NikosLabs/nikoslabs.github.io/articles/am-radio/article.md

---
title: Build an AM Radio!
date: 2026-07-29
author: DemodulatedWave
tags: Radio, AM, Intermediate, Analog, Tutorial, RF, Theory
description: A guide to build a simple AM radio receiver.
image: assets/placeholder.jpg
hidden: true
---

# Getting Started: AM Radio
I will go over how to make a simple AM radio with minimal components and explain how each part works.

## What You'll Need

- Bread board
- AM Antenna or long wire
- Magnet Wire and rod (wood, pvc pipe, but no metal) or Inductor Kit
- Electrolytic Capacitor and Ceramic Capacitor Kit
- Resistor Kit
- Germanium Diode
- Speaker (2Ohm is good)
- 1x LM386 module
- 9V Battery
- (Optional) 3 way guitar switch
- (Optional) On/Off switch (SPST)
- (Optional) 10k logarithmic potentiometer

## Circuit Diagram

Here's the basic circuit we will be looking at:

Graph screenshot

## How It Works

## Antenna

## LC Tank
**How it works**
It can be calculated with:
$$f_0 = \frac{1}{2\pi \sqrt{LC}}$$

**Inductor**
**Capacitor**

## Demodulation
**What is an Envelope detector?**
$$\frac{1}{f_c} \ll RC \ll \frac{1}{f_m}$$
**Diode**
**Resistor**
**Capacitor**

## Amplification
**LM386**
**Importance of Decoupling**

## Troubleshooting

**Static?**
**Hear Nothing?**
**Tuning but no stations?**
**Hand detuning?**

## Next Steps

- Try to tweak inductor values to find more stations
- Make your own specialized AM Antenna
- Make a cool housing for your radio with wood, 3d printing, etc
- If you used an inductor kit, try winding your own inductor!

Enjoy listening to your new home-made AM radio!
