NikosLabs/nikoslabs.github.io/articles/beauty-of-interstellar/article.md

---
title: The Beauty of Interstellar
date: 2026-07-31
author: Niko
tags: Movie, Interstellar, Opinion
description: My takes on Interstellar by Christopher Nolan
image: assets/interstellar.jpg
hidden: true
---

> [!NOTE]
> **SPOILER ALERT** If you haven't watched the movie, go watch it! Then, you can come and read this! Trust me you don't want it spoiled ;)
> ‎ 
> ‎ 
> ‎ 
> ‎ 
> ‎ 

## Why It stands out

For a voltage divider with resistors R₁ and R₂:

## Related Books
Interstellar has a few amazing related books. I've read two of them this summer: *Interstellar: The Official Movie Novelization* by Gregory Keyes and *The Science of Interstellar* by Kip Thorne
### *Interstellar: The Official Movie Novelization* by Gregory Keyes
Placeholder
### *The Science of Interstellar* by Kip Thorne
Placeholder

## Conclusion

Interstellar is a masterpeice.
