NikosLabs/nikoslabs.github.io/assets/laser-radio-header.jpg

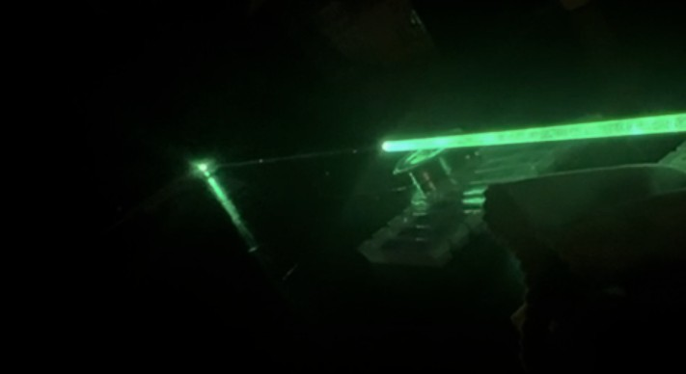
assets/laser-radio-header.jpg
