NikosLabs/nikoslabs.github.io/assets/laser-radio/BoothPhoto.png

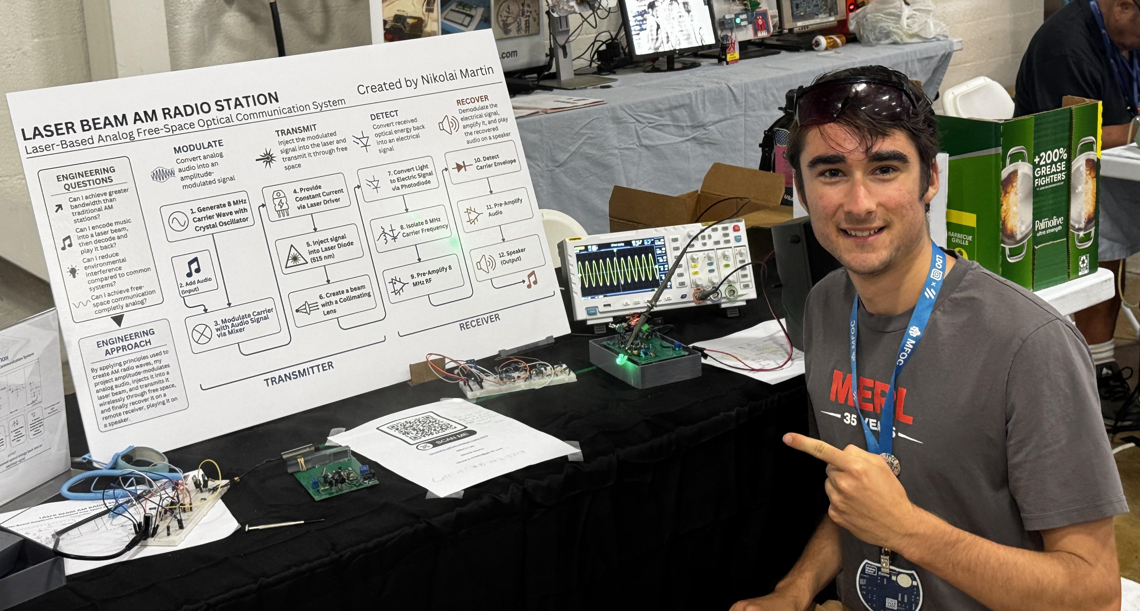
assets/laser-radio/BoothPhoto.png
