NikosLabs/nikoslabs.github.io/assets/laser-radio/breadToPerf.png

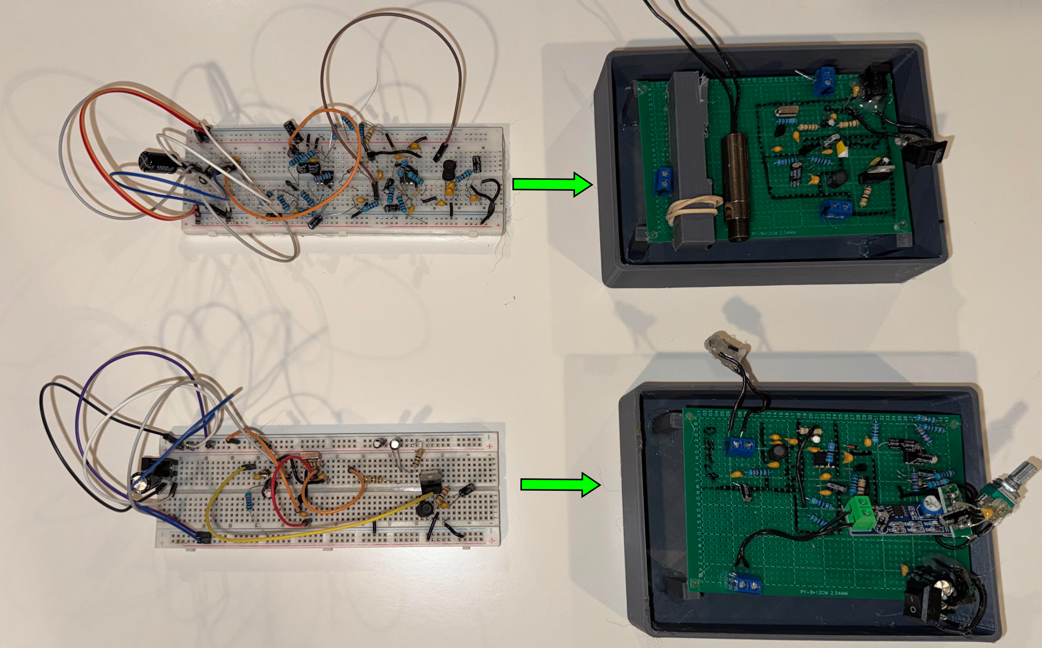
assets/laser-radio/breadToPerf.png
