NikosLabs/nikoslabs.github.io/assets/laser-radio/coverForDemo.png

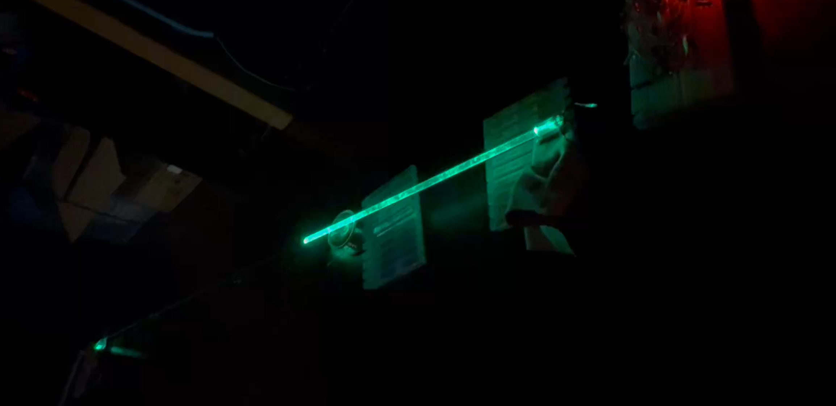
assets/laser-radio/coverForDemo.png
