NikosLabs/nikoslabs.github.io/assets/laser-radio/DetectSchematic.png

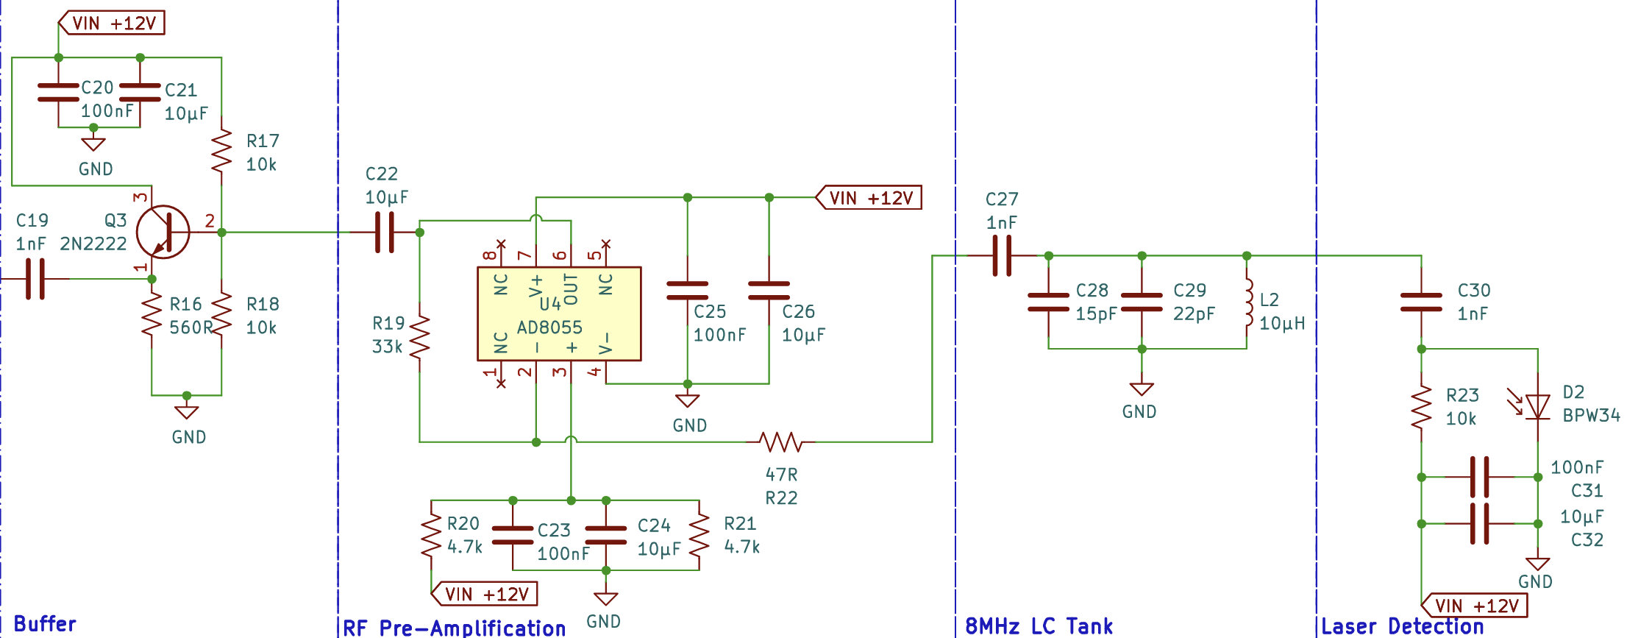
assets/laser-radio/DetectSchematic.png
