NikosLabs/nikoslabs.github.io/assets/laser-radio/laserholder.png

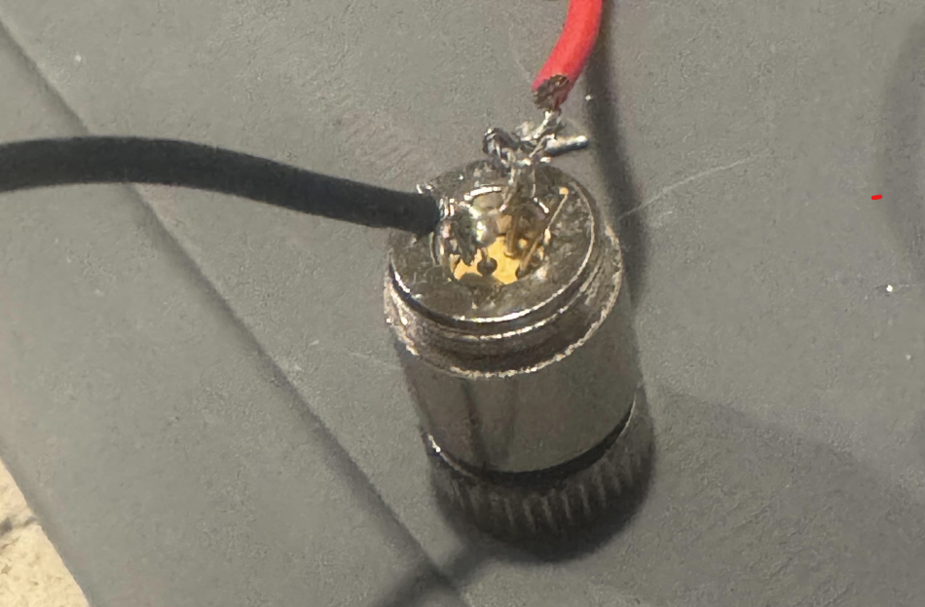
assets/laser-radio/laserholder.png
