NikosLabs/nikoslabs.github.io/assets/laser-radio/ModulateSchematic.png

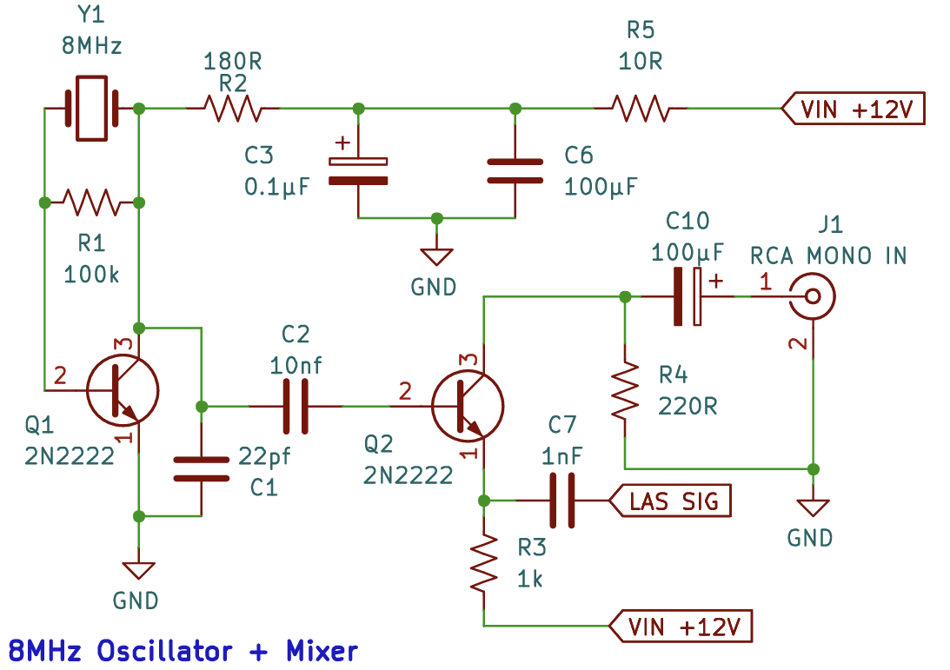
assets/laser-radio/ModulateSchematic.png
