NikosLabs/nikoslabs.github.io/assets/laser-radio/PosterDetect.png

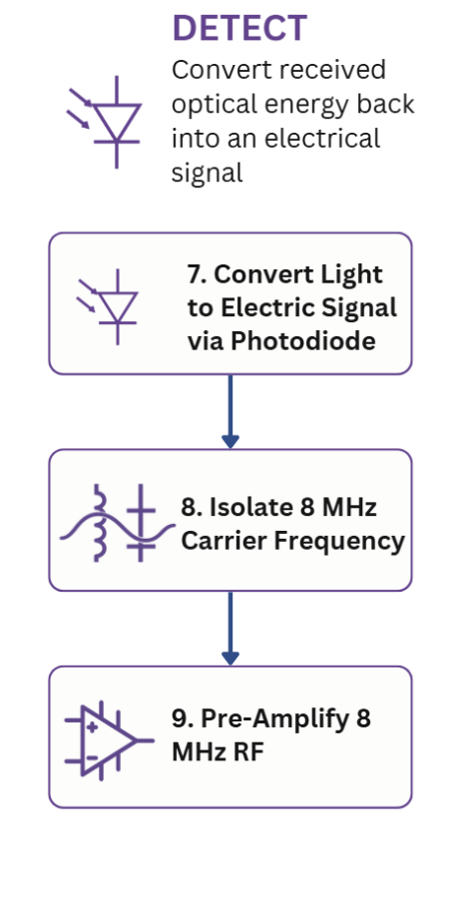
assets/laser-radio/PosterDetect.png
