NikosLabs/nikoslabs.github.io/assets/laser-radio/PosterModulate.png

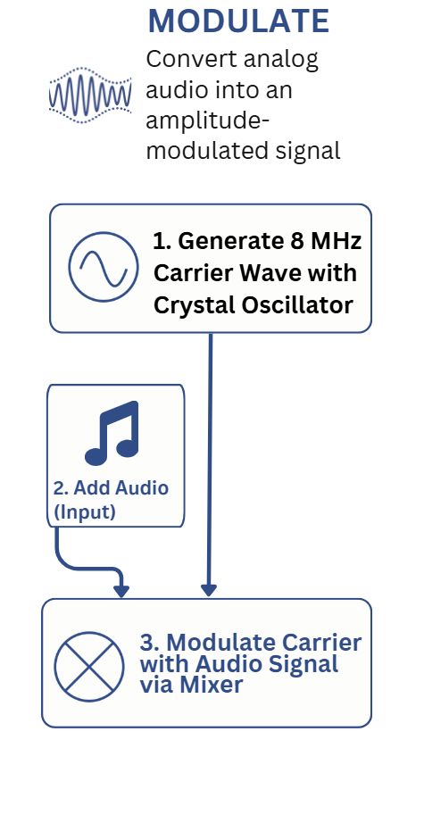
assets/laser-radio/PosterModulate.png
