NikosLabs/nikoslabs.github.io/assets/laser-radio/PosterRecover.png

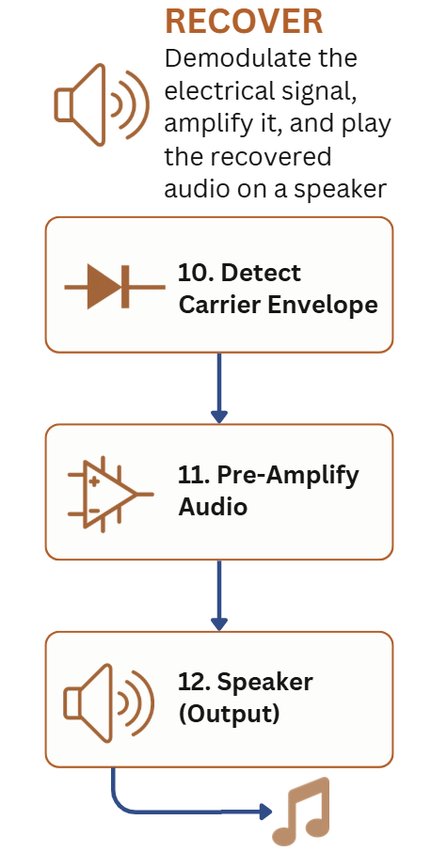
assets/laser-radio/PosterRecover.png
