NikosLabs/nikoslabs.github.io/assets/laser-radio/PosterTransmit.png

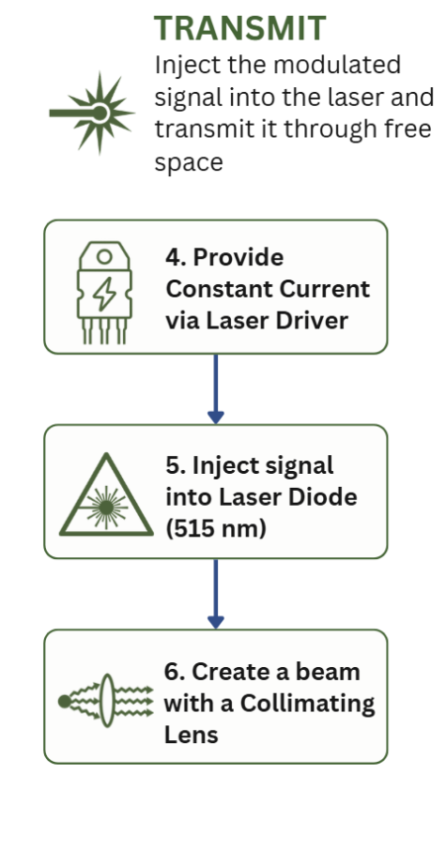
assets/laser-radio/PosterTransmit.png
