NikosLabs/nikoslabs.github.io/assets/laser-radio/Receiver.png

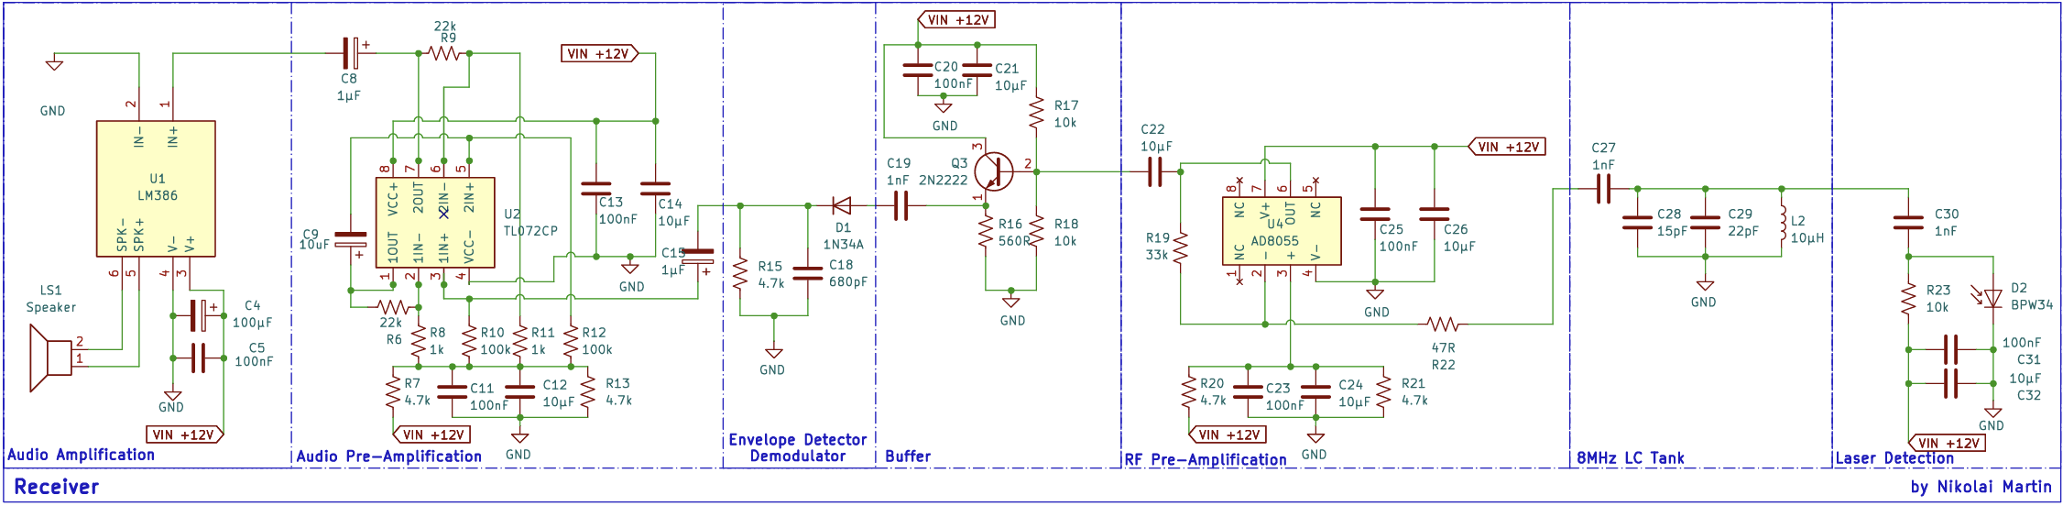
assets/laser-radio/Receiver.png
