NikosLabs/nikoslabs.github.io/assets/laser-radio/RecoverSchematic.png

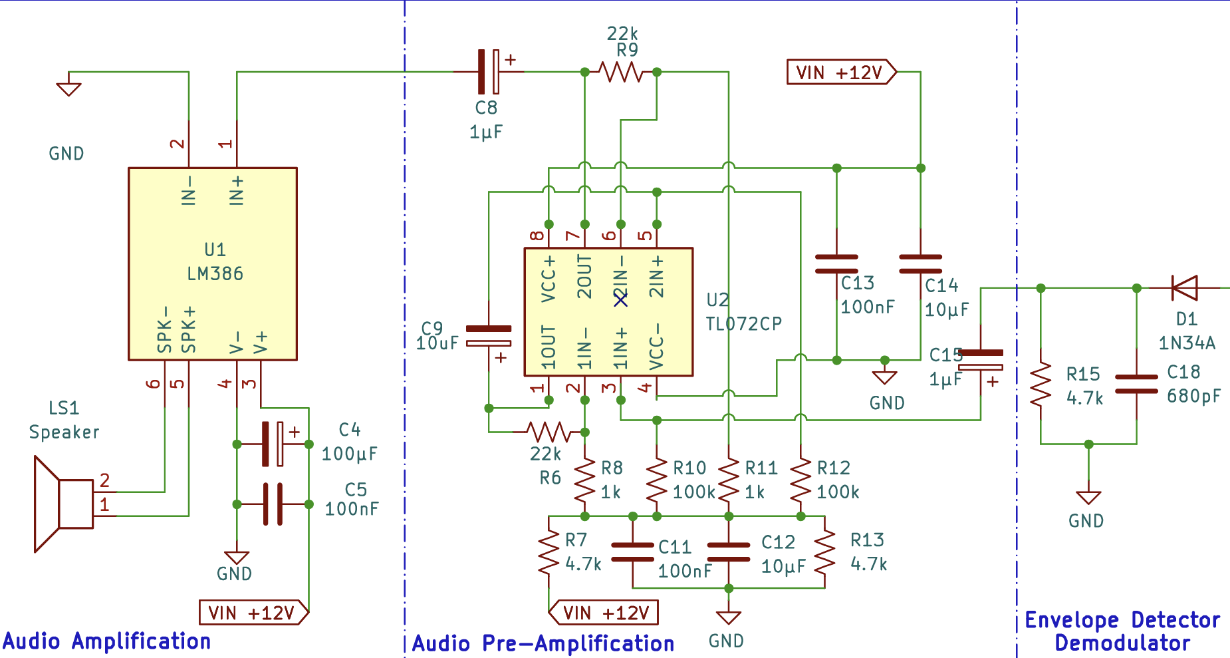
assets/laser-radio/RecoverSchematic.png
