NikosLabs/nikoslabs.github.io/assets/laser-radio/scope8MHz.png

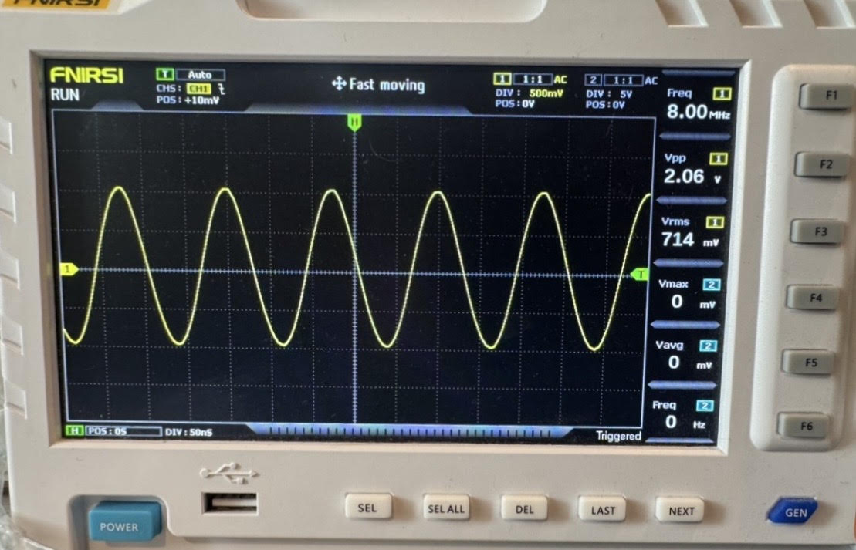
assets/laser-radio/scope8MHz.png
