NikosLabs/nikoslabs.github.io/assets/laser-radio/TransmitSchematic.png

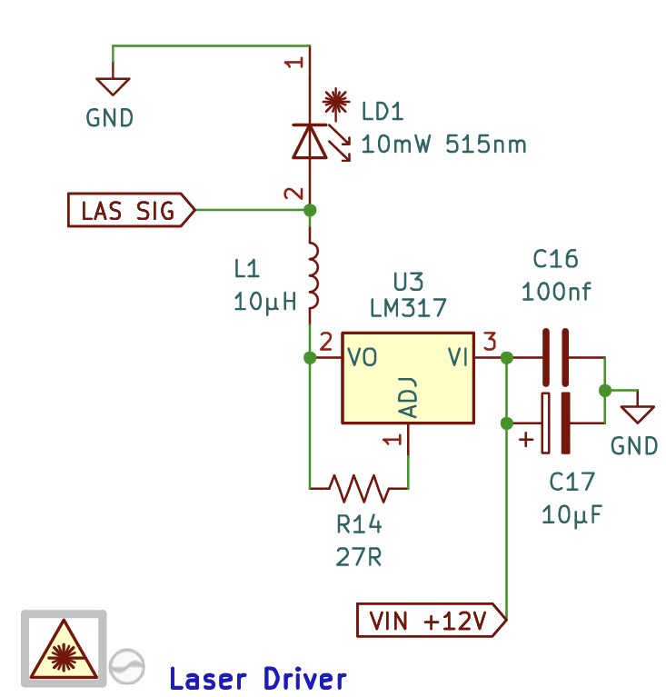
assets/laser-radio/TransmitSchematic.png
