NikosLabs/nikoslabs.github.io/assets/laser-radio/Transmitter.png

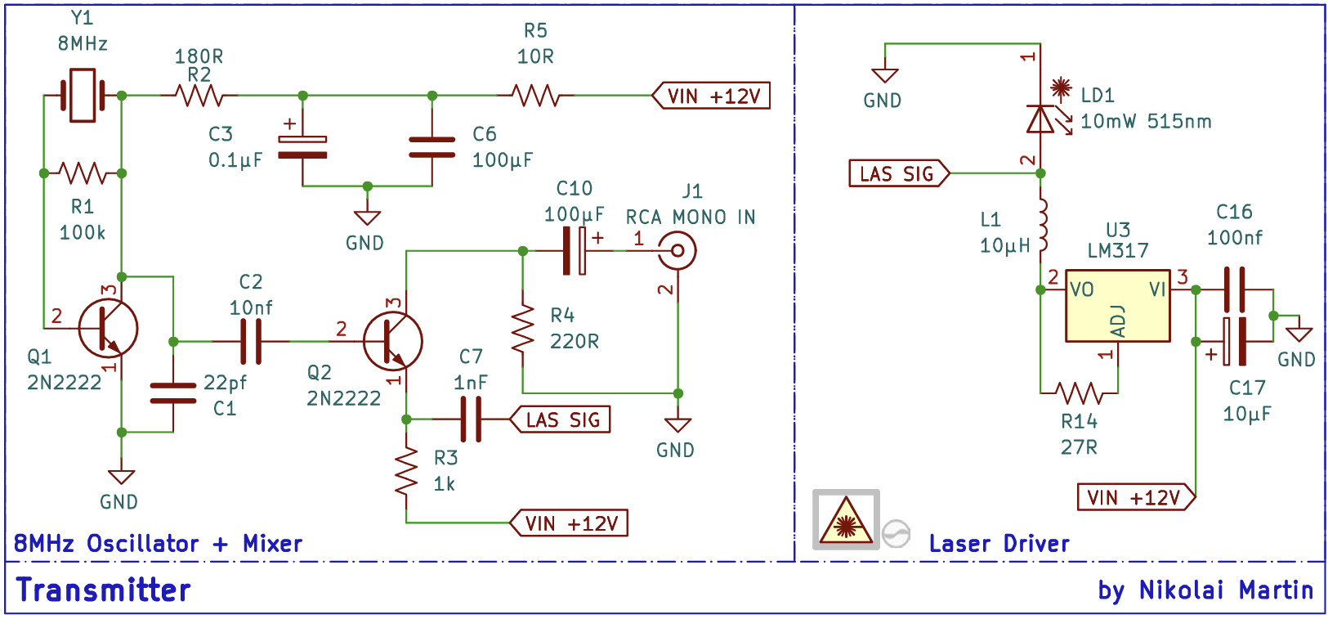
assets/laser-radio/Transmitter.png
