NikosLabs/nikoslabs.github.io/assets/placeholder.jpg

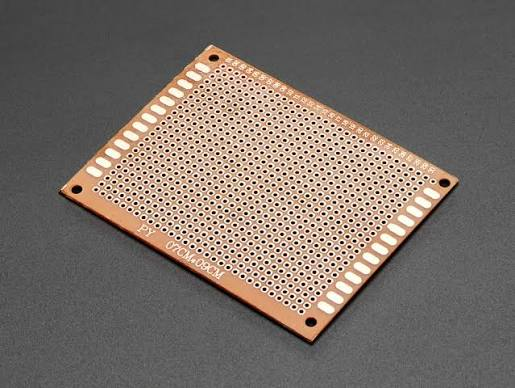
assets/placeholder.jpg
