NikosLabs/nikoslabs.github.io/assets/laser-radio/Cover.stl

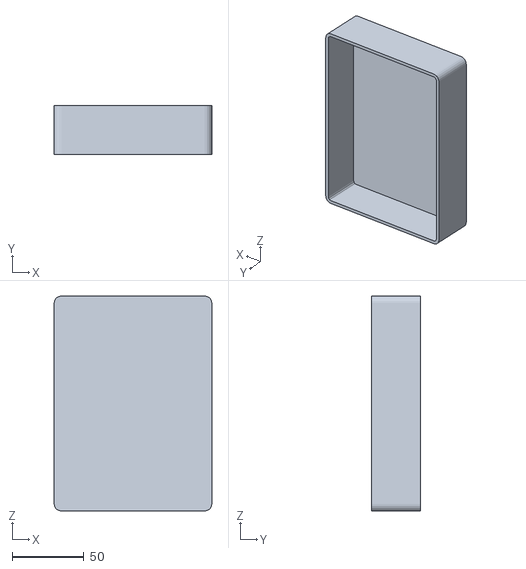
[picture p19: CAD file, 2026-09-21]
assets/laser-radio/Cover.stl
110.0 x 34.0 x 150.0
