NikosLabs/nikoslabs.github.io/assets/laser-radio/TO18holder.stl

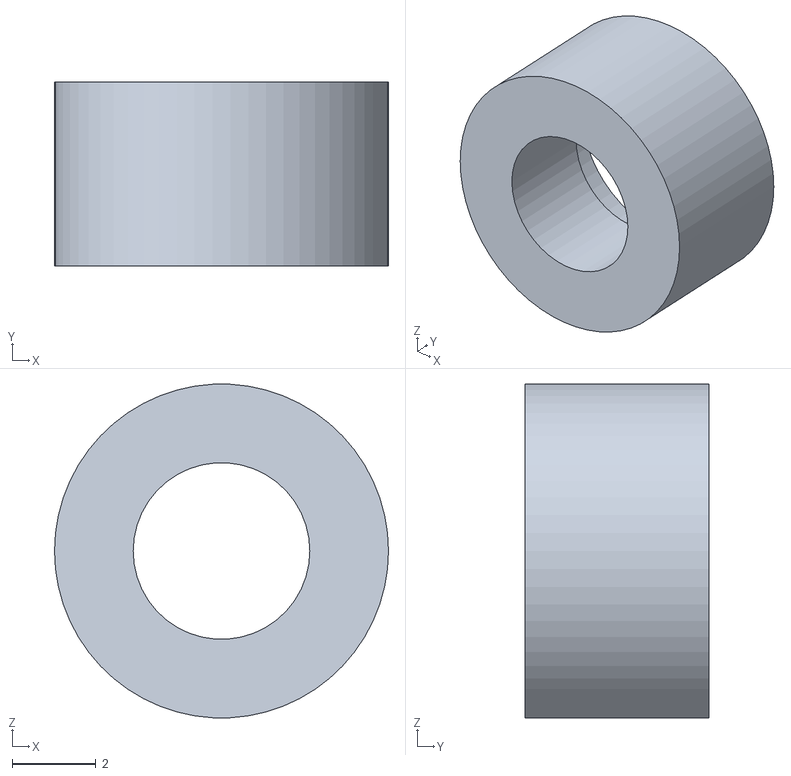
[picture p20: CAD file, 2026-09-21]
assets/laser-radio/TO18holder.stl
8.00 x 4.40 x 7.99
