NikosLabs/nikoslabs.github.io/assets/laser-radio/3dPrintedLaserDiodeHolders.png

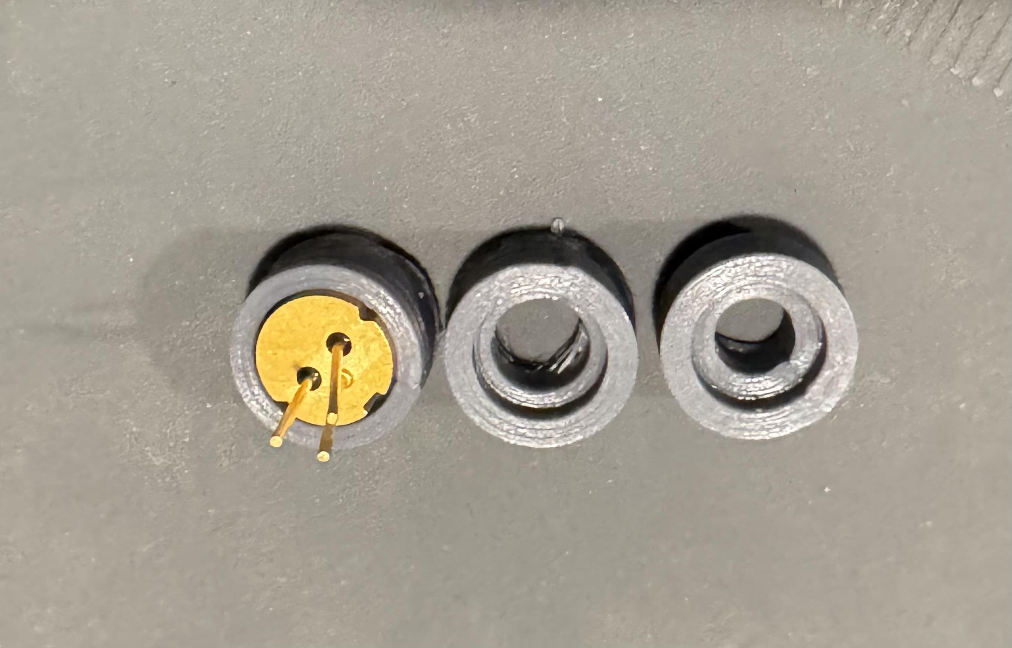
assets/laser-radio/3dPrintedLaserDiodeHolders.png
